Joshua1909/chipshouter-picoemp/hardware/JLCPCB fabrication files/1.jpg

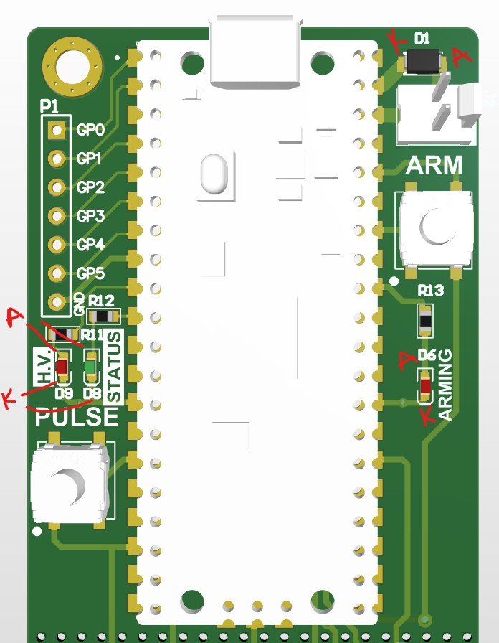
hardware/JLCPCB fabrication files/1.jpg
