Joshua1909/chipshouter-picoemp/hardware/JLCPCB fabrication files/2.jpg

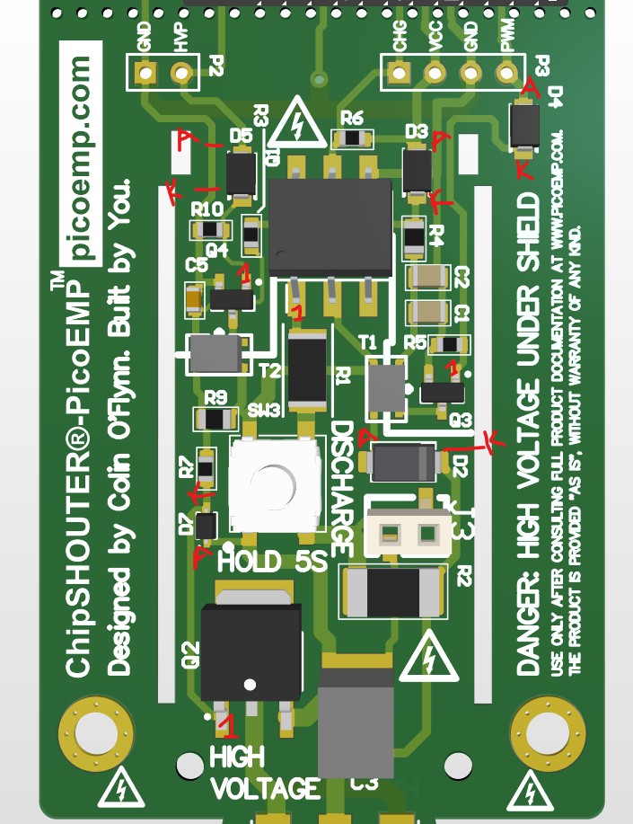
hardware/JLCPCB fabrication files/2.jpg
