Joshua1909/chipshouter-picoemp/hardware/KiCad/chipshouter-pico/chipshouter-pico-jlcpcb-BOM.xlsx

Comment | Designator | Footprint | JLCPCB Part #（optional）
4u7, 50V, 0805, Ceramic | C1, C2 |  | C2167642
0.47uF, 630V, X7T, Stacked | C3 |  | C882504
100n, 0603 | C5 |  | C127833
SM4005PL-TPMSCT-ND | D1, D3, D4, D5 |  | C151774
600V, 1A, Fast Recovery Diode | D2 |  | C50432
Chip LED, Red | D6, D9 |  | C598317
MM3Z18VB | D7 |  | C891584
Chip LED, Green | D8 |  | C5119770
Edge-Mount SMA, 0.062" PCB | J1 |  | C841205
JST XH 0.1" HEADER | J2 |  | C157931
2-Pin SMD, Female Header, 0.1" spacing | J3 |  | C6868880
Phototransistor | Q1 |  | C17531663
IGBT 650V | Q2 |  | C3193927
MOSFET N-CH 30V 2.2A SOT23-3 | Q3, Q4 |  | C37130
20M, 2010, 1% | R1 |  | C2091374
300K res, 2512, 1%, 3W | R2 |  | C4262190
10R res, 0603, 1%, 1/10W | R3, R7 |  | C109318
75R res, 0805, 1%, 1/8W | R4 |  | C141697
1k res, 0603, 1%, 1/10W | R5, R10, R11, R12, R13 |  | C22548
22k res, 0603, 1%, 1/10W | R6 |  | C114065
2k, 0805, 1%, 1/8W | R9 |  | C114572
SWITCH TACTILE SPST-NO 0.01A 32V | SW1, SW2 |  | C221766
SWITCH TACTILE SPST-NO 0.01A 32V | SW3 |  | C273520
HV Transformer 1:10, Small | T1, T2 |  | C249001
