Joshua1909/chipshouter-picoemp/hardware/JLCPCB fabrication files/BOM.xlsx

Reference | Value | Footprint | Datasheet | Cost | Mfg PN | Vendor Link | Vendor PN | Qty
C1, C2 | 4.7uF/50V | CAP_0805 | https://jlc-prod-smt.oss-eu-central-1.aliyuncs.com/smtDataManualFile/8588884060223102976-C319187.pdf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 | 0.1014 | C2012X5R1H475KT000N | https://jlcpcb.com/partdetail/TDK-C2012X5R1H475KT000N/C319187 | C319187 | 2 | 0.2028
C3 | 0.47uF,630V,X7T | CAP_2220 | https://jlc-prod-smt.oss-eu-central-1.aliyuncs.com/smtDataManualFile/8588934341627535360-C692326.pdf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 | 0.4898 | FM55X474K631EFG | https://jlcpcb.com/partdetail/724209-FM55X474K631EFG/C692326 | C692326 | 1 | 0.4898
C5 | 100nF | CAP_0603 | https://jlc-prod-smt.oss-eu-central-1.aliyuncs.com/smtDataManualFile/8588899315188715520-C127833.pdf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 | 0.0264 | C0603C104K5RACTU | https://jlcpcb.com/partdetail/KEMET-C0603C104K5RACTU/C127833 | C127833 | 1 | 0.0264
D1, D3, D4, D5 | SM4005PL-TP | SOD-123FL | https://jlc-prod-smt.oss-eu-central-1.aliyuncs.com/smtDataManualFile/8588880606779854848-C151774.pdf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 | 0.023 | SM4005PL-TP | https://jlcpcb.com/partdetail/163114-SM4005PLTP/C151774 | C151774 | 4 | 0.092
D2 | MURA160T3G | DO-214AC | https://jlc-prod-smt.oss-eu-central-1.aliyuncs.com/smtDataManualFile/8586178987718545408-C50432.pdf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 | 0.2729 | MURA160T3G | https://jlcpcb.com/partdetail/onsemi-MURA160T3G/C50432 | C50432 | 1 | 0.2729
D6, D9 | LED, 0603, Red | LED_0603 | https://www.we-online.com/components/products/datasheet/150060SS75000.pdf | 0.2382 | 150060SS75000 | https://jlcpcb.com/partdetail/WurthElektronik-150060SS75000/C6784992 | C6784992 | 2 | 0.4764
D7 | MM3Z18VB | SOD_323FL | https://jlc-prod-smt.oss-eu-central-1.aliyuncs.com/smtDataManualFile/8589985941353377792-C891584.pdf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 | 0.102 | MM3Z18VB | https://jlcpcb.com/partdetail/onsemi-MM3Z18VB/C891584 | C891584 | 1 | 0.102
D8 | LED, 0603, Green | LED_0603 | https://jlc-prod-smt.oss-eu-central-1.aliyuncs.com/smtDataManualFile/8589784767215263744-C5119770.pdf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 | 0.098 | APT1608CGCK | https://jlcpcb.com/partdetail/Kingbright-APT1608CGCK/C5119770 | C5119770 | 1 | 0.098
J1 | EDGE-SMA |  | https://www.molex.com/content/dam/molex/molex-dot-com/products/automated/en-us/salesdrawingpdf/732/73251/732511150_sd.pdf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 | 4.0121 | 732511150 | https://jlcpcb.com/partdetail/MOLEX-732511150/C841205 | C841205 | 1 | 4.0121
J2 | 1x2_Pin_Header |  | https://jlc-prod-smt.oss-eu-central-1.aliyuncs.com/smtDataManualFile/8588891957980770304-C157931.pdf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 | 0.0796 | S2B-XH-A(LF)(SN) | https://jlcpcb.com/partdetail/JST-S2B_XH_A_LF_SN/C157931 | C157931 | 1 | 0.0796
J3 | BG306-02-A-2-0400-L-G |  | https://jlc-prod-smt.oss-eu-central-1.aliyuncs.com/smtDataManualFile/8603349436185923584-C6868880.pdf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 | 0.4543 | BG306-02-A-2-0400-L-G | https://jlcpcb.com/partdetail/7832696-BG306_02_A_2_0400_LG/C6868880 | C6868880 | 1 | 0.4543
Q1 | LDA111STR | SOP254P952X470-6N | https://jlc-prod-smt.oss-eu-central-1.aliyuncs.com/smtDataManualFile/8600572786679570432-C17531663.pdf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 | 1.7943 | LDA111STR | https://jlcpcb.com/partdetail/LittelfuseIXYS-LDA111STR/C17531663 | C17531663 | 1 | 1.7943
Q2 | RGT16BM65DTL | DPAK_TO-252AA | https://jlc-prod-smt.oss-eu-central-1.aliyuncs.com/smtDataManualFile/8757845658760437760-C3193927.pdf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 | 1.6262 | RGT16BM65DTL | https://jlcpcb.com/partdetail/ROHMSemicon-RGT16BM65DTL/C3193927 | C3193927 | 1 | 1.6262
Q3, Q4 | AO3422 | SOT-23 | https://jlc-prod-smt.oss-eu-central-1.aliyuncs.com/smtDataManualFile/8586177051322175488-C37130.pdf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 | 0.1454 | AO3422 | https://jlcpcb.com/partdetail/Alpha_OmegaSemicon-AO3422/C37130 | C37130 | 2 | 0.2908
R1 | 20M | RES_2010_5025 | https://jlc-prod-smt.oss-eu-central-1.aliyuncs.com/smtDataManualFile/8589810091047354368-C2091374.pdf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 | 0.8552 | CRMA2010AF20M0FKEF | https://jlcpcb.com/partdetail/VishayIntertech-CRMA2010AF20M0FKEF/C2091374 | C2091374 | 1 | 0.8552
R2 | 300K | RES_2512_6432 | https://jlc-prod-smt.oss-eu-central-1.aliyuncs.com/smtDataManualFile/8590415173204156416-C4262190.pdf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 | 1.012 | 3522300KFT | https://jlcpcb.com/partdetail/TEConnectivity-3522300KFT/C4262190 | 3522300KFT | 1 | 1.012
R3, R7 | 10R | RES_0603 | https://jlc-prod-smt.oss-eu-central-1.aliyuncs.com/smtDataManualFile/8755823741106700288-C109318.pdf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 | 0.011 | RC0603FR-0710RL | https://jlcpcb.com/partdetail/YAGEO-RC0603FR0710RL/C109318 | C109318 | 2 | 0.022
R4 | 75R | RES_0805 | https://jlc-prod-smt.oss-eu-central-1.aliyuncs.com/smtDataManualFile/8755571120823386112-C141697.pdf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 | 0.008 | RC0805FR-0775RL | https://jlcpcb.com/partdetail/YAGEO-RC0805FR0775RL/C141697 | C141697 | 1 | 0.008
R5, R10, R11, R12, R13 | 1k | RES_0603 | https://jlc-prod-smt.oss-eu-central-1.aliyuncs.com/smtDataManualFile/8716419542295400448-C22548.pdf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 | 0.0062 | RC0603FR-071KL | https://jlcpcb.com/partdetail/YAGEO-RC0603FR071KL/C22548 | C22548 | 5 | 0.031
R6 | 22k | RES_0603 | https://jlc-prod-smt.oss-eu-central-1.aliyuncs.com/smtDataManualFile/8755542435072225280-C114065.pdf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 | 0.0053 | RC0603FR-0722KL | https://jlcpcb.com/partdetail/YAGEO-RC0603FR0722KL/C114065 | C114065 | 1 | 0.0053
R9 | 2k | RES_0805 | https://jlc-prod-smt.oss-eu-central-1.aliyuncs.com/smtDataManualFile/8755566388566208512-C114572.pdf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 | 0.0089 | RC0805FR-072KL | https://jlcpcb.com/partdetail/YAGEO-RC0805FR072KL/C114572 | C114572 | 1 | 0.0089
SW1, SW2, SW3 | KSC741JLFS | SMD-4P,6.2x6.2mm | https://jlc-prod-smt.oss-eu-central-1.aliyuncs.com/smtDataManualFile/8588903739336110080-C221766.pdf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 | 0.6822 | KSC741JLFS | https://jlcpcb.com/partdetail/CK-KSC741JLFS/C221766 | C221766 | 3 | 2.0466
T1, T2 | ATB322524 | SMD-4P,3.2x2.5mm | https://jlc-prod-smt.oss-eu-central-1.aliyuncs.com/smtDataManualFile/8558282382320029696-C249001.pdf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 | 0.8051 | ATB322524-0110-T000 | https://jlcpcb.com/partdetail/TDK-ATB322524_0110T000/C249001 | C249001 | 2 | 1.6102
U1 | Raspberry Pi Pico |  | https://jlc-prod-smt.oss-eu-central-1.aliyuncs.com/smtDataManualFile/8590904656052895744-C7203002.pdf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 | 7.0672 | Raspberry Pi Pico | https://jlcpcb.com/partdetail/RaspberryPi-Raspberry_PiPico/C7203002 | C7203002 | 1 | 7.0672
BH1 | PRT-09925 |  |  |  |  | no stock |  | 1 | 0
 |  |  |  |  |  |  |  | TOTAL | 22.68
