Joshua1909/chipshouter-picoemp/hardware/KiCad/chipshouter-pico/Schematic.pdf

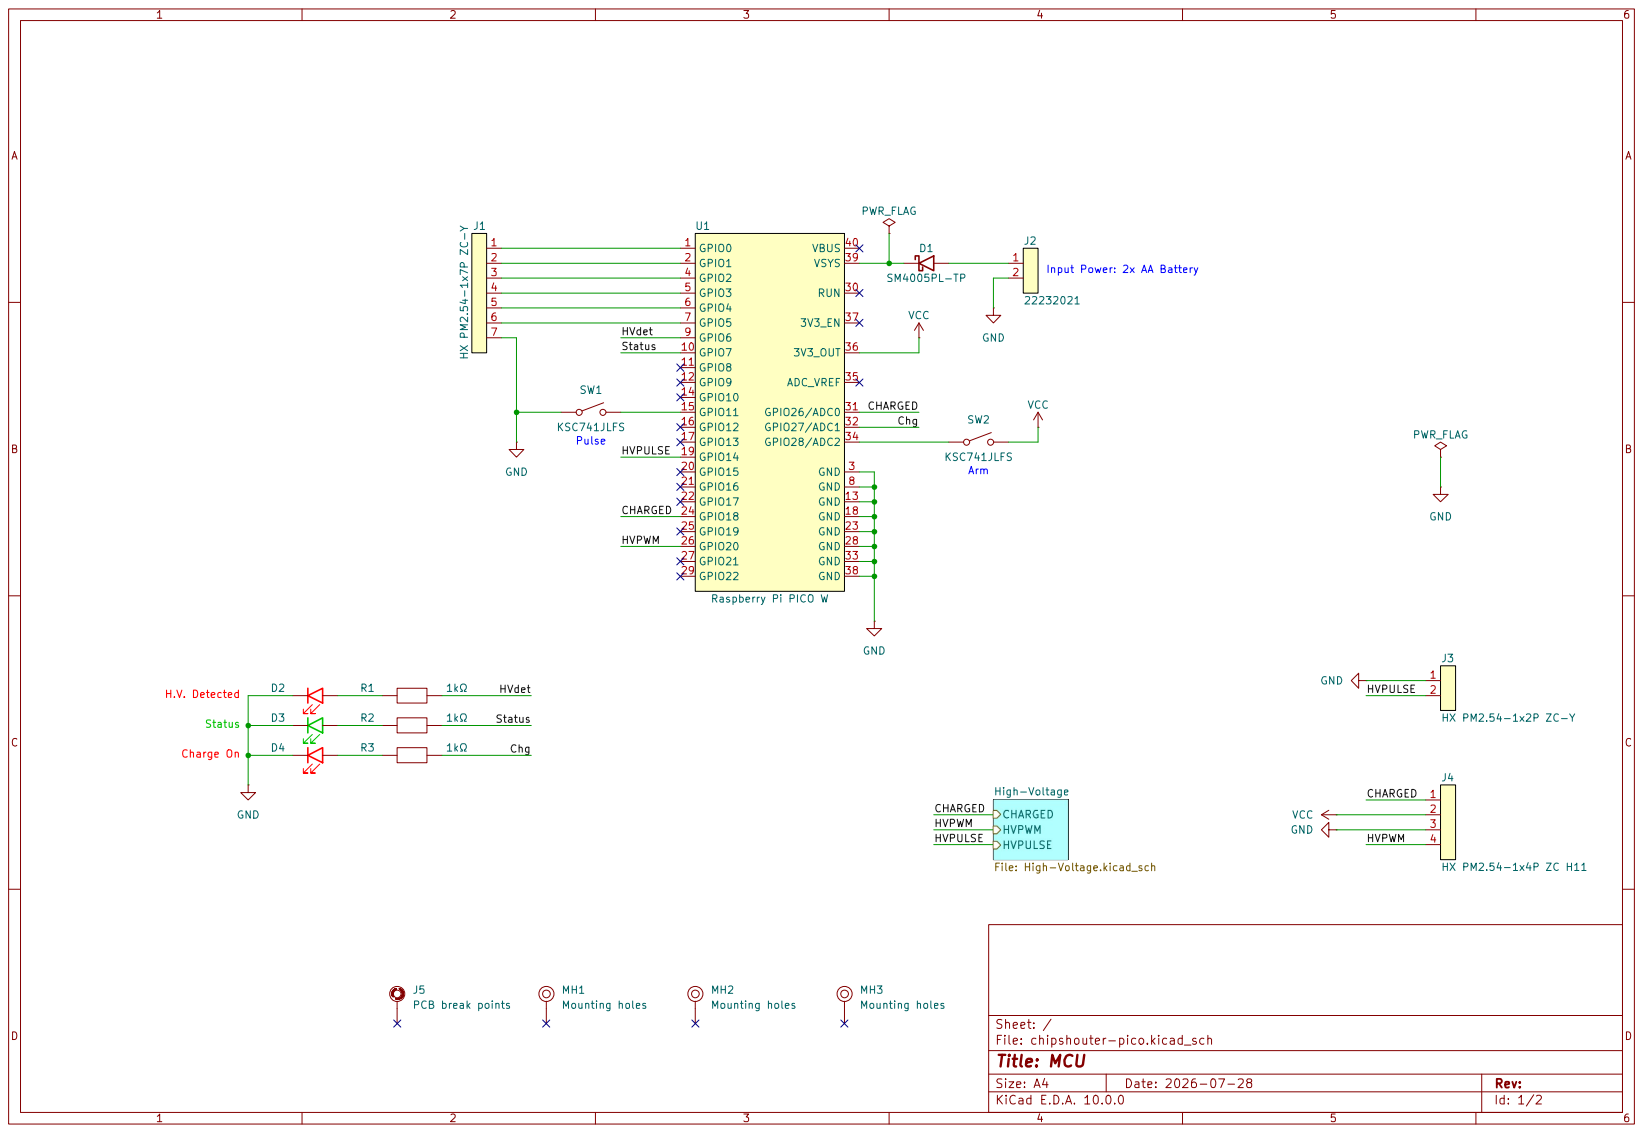
[picture p3: page 1]

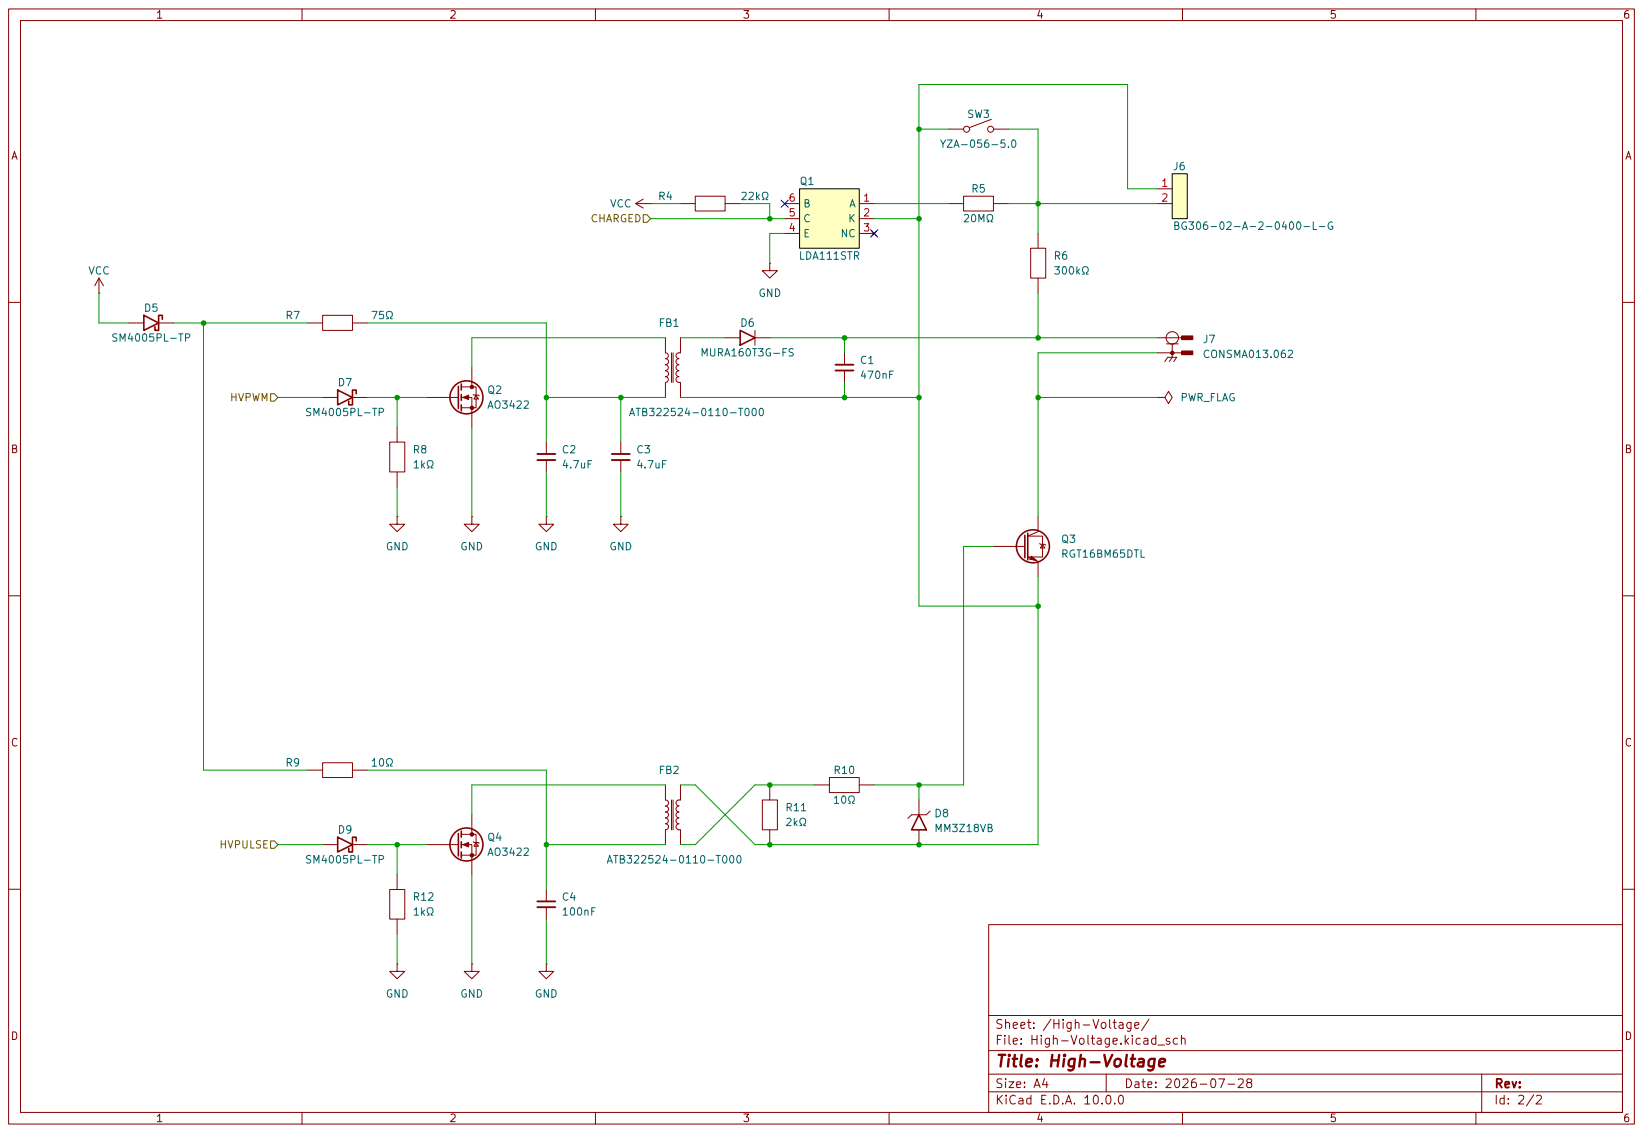
[picture p4: page 2]
