Joshua1909/chipshouter-picoemp/hardware/KiCad/chipshouter-pico/chipshouter-pico.kicad_pcb

## KiCad design hardware/KiCad/chipshouter-pico/chipshouter-pico.kicad_pcb (2026-08-18)

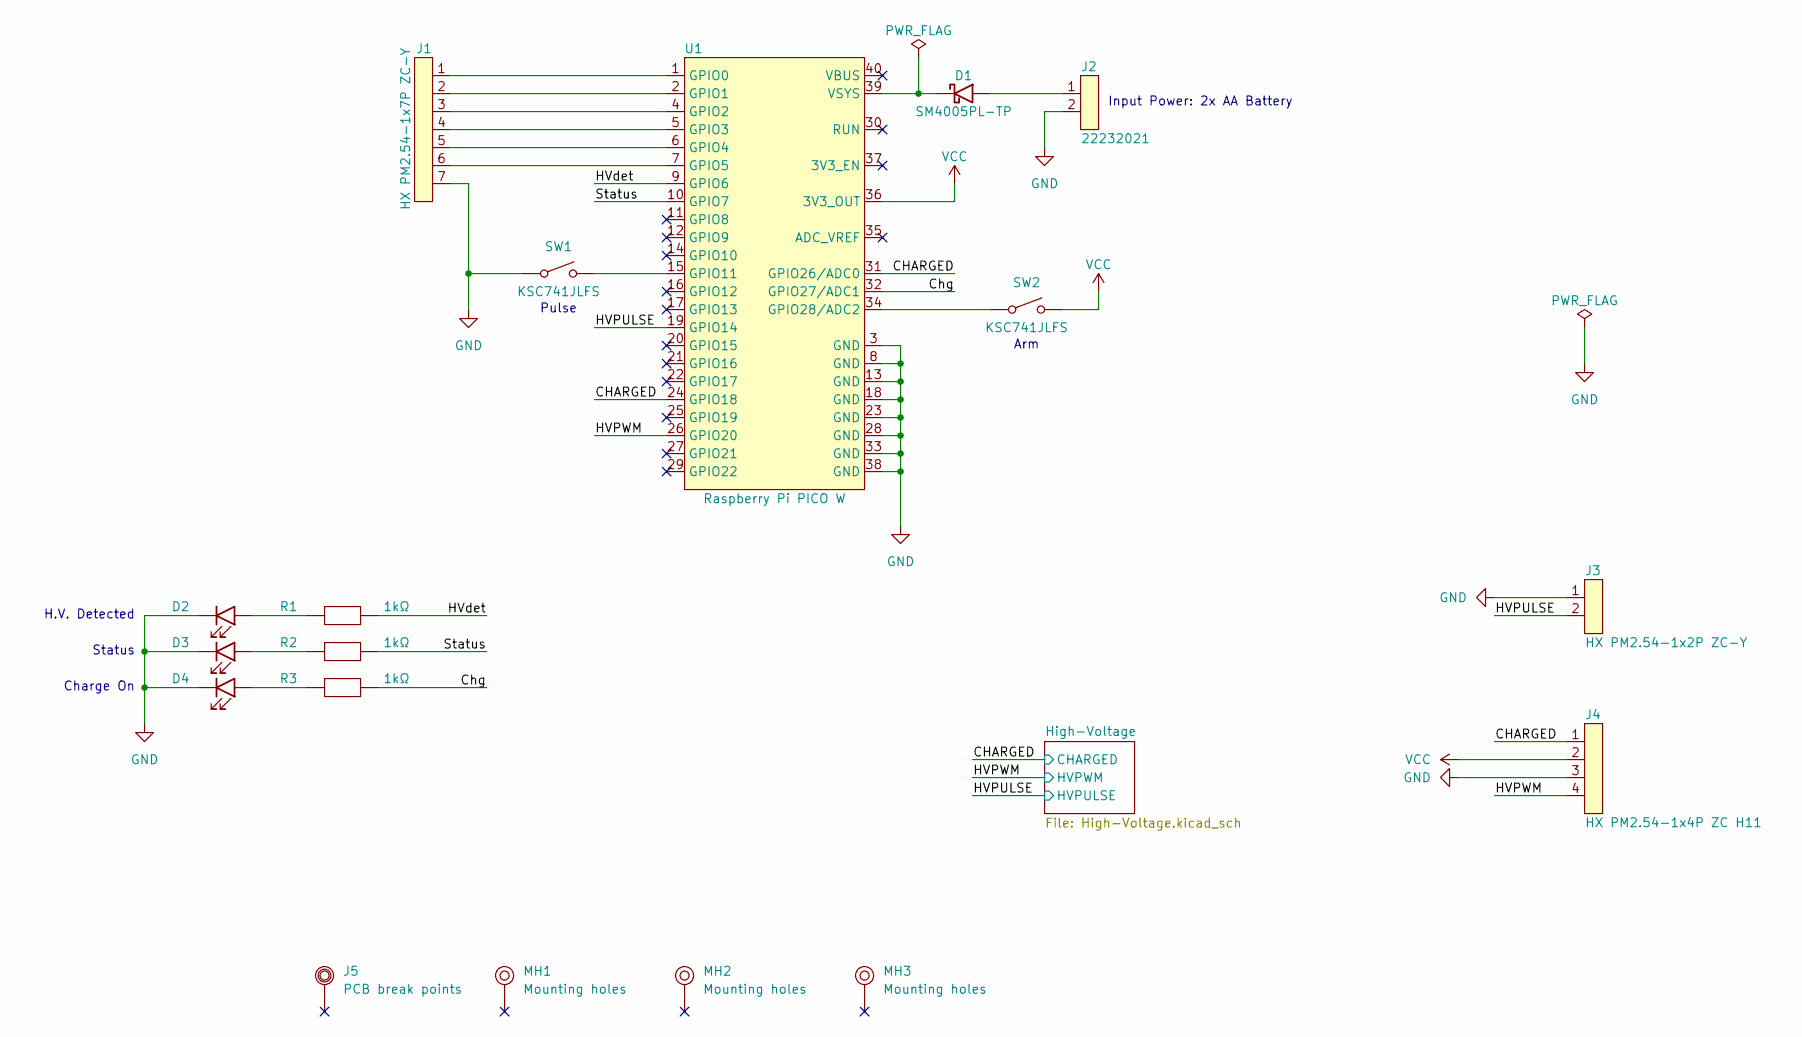
[picture p5: schematic chipshouter-pico.kicad_sch, MCU]

Parts:
D1: SM4005PL-TP; Manufacturer Part Numbe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 SM4005PL-TP
D2, D4: LED Red; 19-217/R6C-AL1M2VY/6T; Manufacturer Part Numbe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 19-217/R6C-AL1M2VY/6T
D3: LED Green; 19-219/GHC-YR2T1B5Y/3T; Manufacturer Part Numbe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 19-219/GHC-YR2T1B5Y/3T
J1: HX PM2.54-1x7P ZC-Y; Manufacturer Part Numbe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 HX PM2.54-1x7P ZC-Y
J2: 22232021; Manufacturer Part Numbe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 22232021
J3: HX PM2.54-1x2P ZC-Y; Manufacturer Part Numbe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 HX PM2.54-1x2P ZC-Y
J4: HX PM2.54-1x4P ZC H11; Manufacturer Part Numbe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 HX PM2.54-1x4P ZC H11
J5: PCB break points; PCB BREAK POINTS
MH1, MH2, MH3: Mounting holes; MOUNTING HOLES
R1, R2, R3: 1kΩ; YAGEO_RES0603; Manufacturer Part Numbe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 RC0603FR-071KL
SW1, SW2: KSC741JLFS; Manufacturer Part Numbe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 KSC741JLFS
U1: Raspberry Pi PICO W; Manufacturer Part Numbe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 PICO W

Connections:
/CHARGED: J4.1, U1.24 (GPIO18), U1.31 (GPIO26/ADC0); also elsewhere on the board
/Chg: R3.2, U1.32 (GPIO27/ADC1)
/HVPULSE: J3.2, U1.19 (GPIO14); also elsewhere on the board
/HVPWM: J4.4, U1.26 (GPIO20); also elsewhere on the board
/HVdet: R1.2, U1.9 (GPIO6)
/Status: R2.2, U1.10 (GPIO7)
GND: D2.1 (K), D3.1 (K), D4.1 (K), J1.7, J2.2, J3.1, J4.3, SW1.1, U1.3 (GND), U1.8 (GND), U1.13 (GND), U1.18 (GND), U1.23 (GND), U1.28 (GND), U1.33 (GND), U1.38 (GND); also elsewhere on the board
unnamed: D1.2 (A), J2.1
unnamed: D1.1 (K), U1.39 (VSYS)
unnamed: D2.2 (A), R1.1
unnamed: D3.2 (A), R2.1
unnamed: D4.2 (A), R3.1
unnamed: J1.1, U1.1 (GPIO0)
unnamed: J1.2, U1.2 (GPIO1)
unnamed: J1.3, U1.4 (GPIO2)
unnamed: J1.4, U1.5 (GPIO3)
unnamed: J1.5, U1.6 (GPIO4)
unnamed: J1.6, U1.7 (GPIO5)
unnamed: SW1.2, U1.15 (GPIO11)
unnamed: SW2.1, U1.34 (GPIO28/ADC2)
VCC: J4.2, SW2.2, U1.36 (3V3_OUT); also elsewhere on the board

Notes on the sheet:
Arm
H.V. Detected
Input Power: 2x AA Battery
Status
Charge On
Pulse

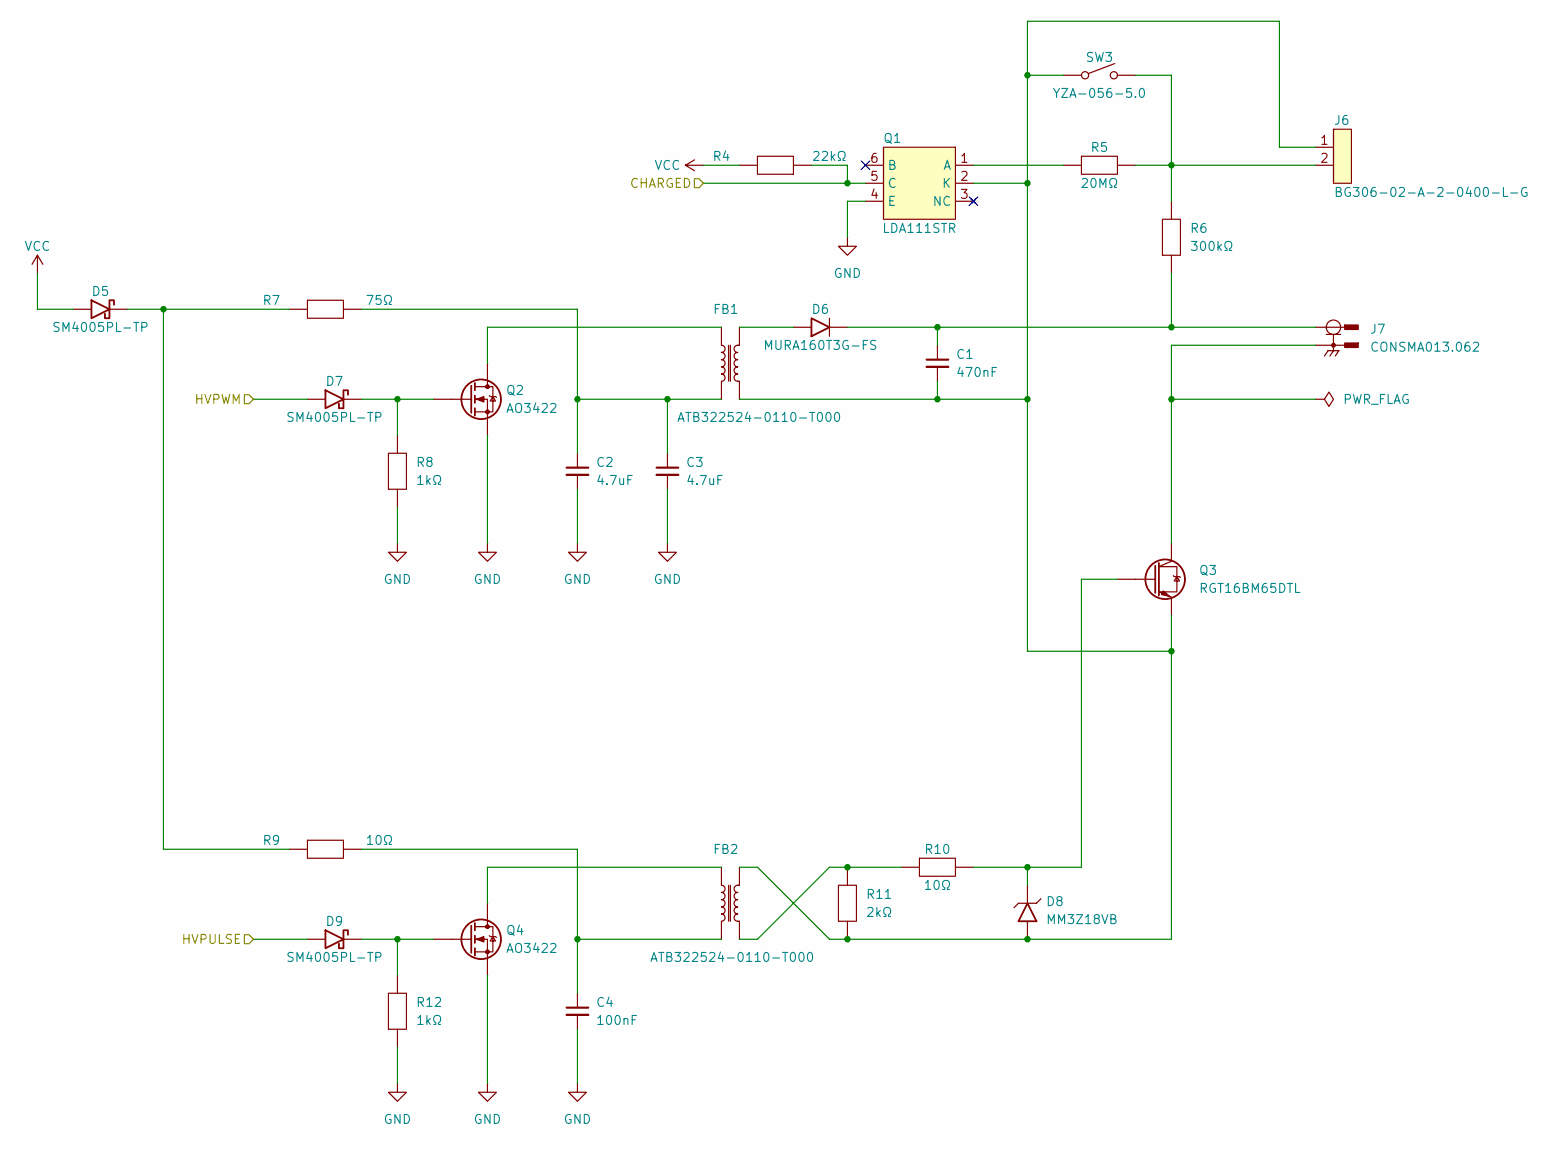
[picture p6: schematic High-Voltage.kicad_sch]

Parts:
C1: 470nF; CKG57NX7R2J474MT009W; Manufacturer Part Numbe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 CKG57NX7R2J474MT009W
C2, C3: 4.7uF; CL21A475KBQNNNE; Manufacturer Part Numbe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 CL21A475KBQNNNE
C4: 100nF; C0603C104K5RACTU; Manufacturer Part Numbe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 C0603C104K5RACTU
D5, D7, D9: SM4005PL-TP; Manufacturer Part Numbe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 SM4005PL-TP
D6: MURA160T3G-FS; Manufacturer Part Numbe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 MURA160T3G-FS
D8: MM3Z18VB; Manufacturer Part Numbe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 MM3Z18VB
FB1, FB2: ATB322524-0110-T000; Manufacturer Part Numbe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 ATB322524-0110-T000
J6: BG306-02-A-2-0400-L-G; Manufacturer Part Numbe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 BG306-02-A-2-0400-L-G
J7: CONSMA013.062; Manufacturer Part Numbe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 CONSMA013.062
Q1: LDA111STR; Manufacturer Part Numbe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 LDA111STR
Q2, Q4: AO3422; Manufacturer Part Numbe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 AO3422
Q3: RGT16BM65DTL; Manufacturer Part Numbe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 RGT16BM65DTL
R4: 22kΩ; YAGEO_RES0603; Manufacturer Part Numbe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 RC0603FR-0722KL
R5: 20MΩ; CRMA2010AF20M0FKEF; Manufacturer Part Numbe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 CRMA2010AF20M0FKEF
R6: 300kΩ; 3522300KFT; Manufacturer Part Numbe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 3522300KFT
R7: 75Ω; YAGEO_RES0603; Manufacturer Part Numbe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 RC0603JR-0775RL
R8, R12: 1kΩ; YAGEO_RES0603; Manufacturer Part Numbe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 RC0603FR-071KL
R9, R10: 10Ω; YAGEO_RES0603; Manufacturer Part Numbe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 RC0603FR-0710RL
R11: 2kΩ; YAGEO_RES0603; Manufacturer Part Numbe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 RC0603FR-072KL
SW3: YZA-056-5.0; Manufacturer Part Numbe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 YZA-056-5.0

Connections:
/CHARGED: Q1.5 (C), R4.1; also elsewhere on the board
/HVPULSE: D9.2 (A); also elsewhere on the board
/HVPWM: D7.2 (A); also elsewhere on the board
GND: C2.2, C3.2, C4.2, Q1.4 (E), Q2.2 (S), Q4.2 (S), R8.1, R12.1; also elsewhere on the board
unnamed: C2.1, C3.1, FB1.4, R7.2
unnamed: C4.1, FB2.4, R9.2
unnamed: D5.1 (K), R7.1, R9.1
unnamed: D6.2 (A), FB1.2
unnamed: C1.1, D6.1 (K), J7.1 (SIG), R6.1
unnamed: D7.1 (K), Q2.1 (G), R8.2
unnamed: C1.2, D8.1 (A), FB1.3, FB2.2, J6.1, Q1.2 (K), Q3.3 (E), R11.1, SW3.1
unnamed: D8.2 (K), Q3.1 (G), R10.2
unnamed: D9.1 (K), Q4.1 (G), R12.2
unnamed: FB2.3, R10.1, R11.2
unnamed: J6.2, R5.2, R6.2, SW3.2
unnamed: J7.2 (SH), Q3.4 (C)
unnamed: Q1.1 (A), R5.1
unnamed: FB1.1, Q2.3 (D)
unnamed: FB2.1, Q4.3 (D)
VCC: D5.2 (A), R4.2; also elsewhere on the board

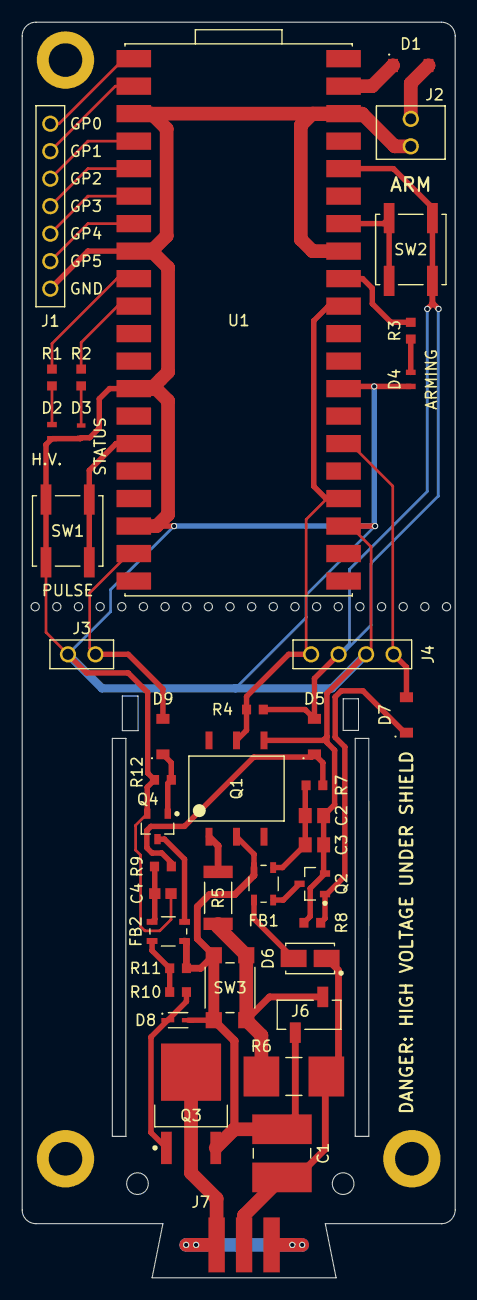
[picture p7: board chipshouter-pico.kicad_pcb from above]

Board: 2 copper layers, 40.0 x 116.0 mm, 45 parts (0 on the bottom side), 36 nets.
